keywish/keywish-panther-tank/README.md

# Please Contact Us

Technical support email: abbott@emakefun.com </br>
Sales email: ken@keywish-robot.com</br>
The latest information download address: https://github.com/keywish/keywish-panther-tank
# The branch switch method
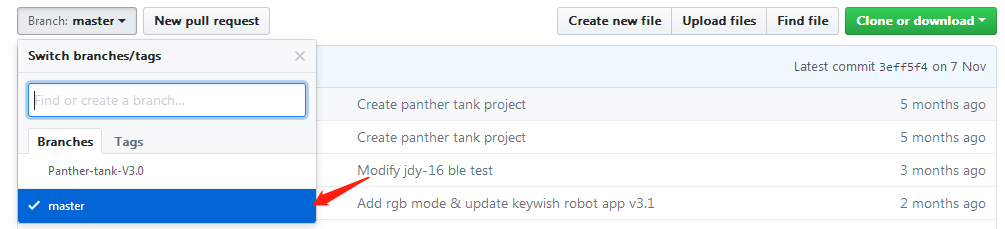
[picture p1: Mast Branch Choose.png]

# Panther-tank
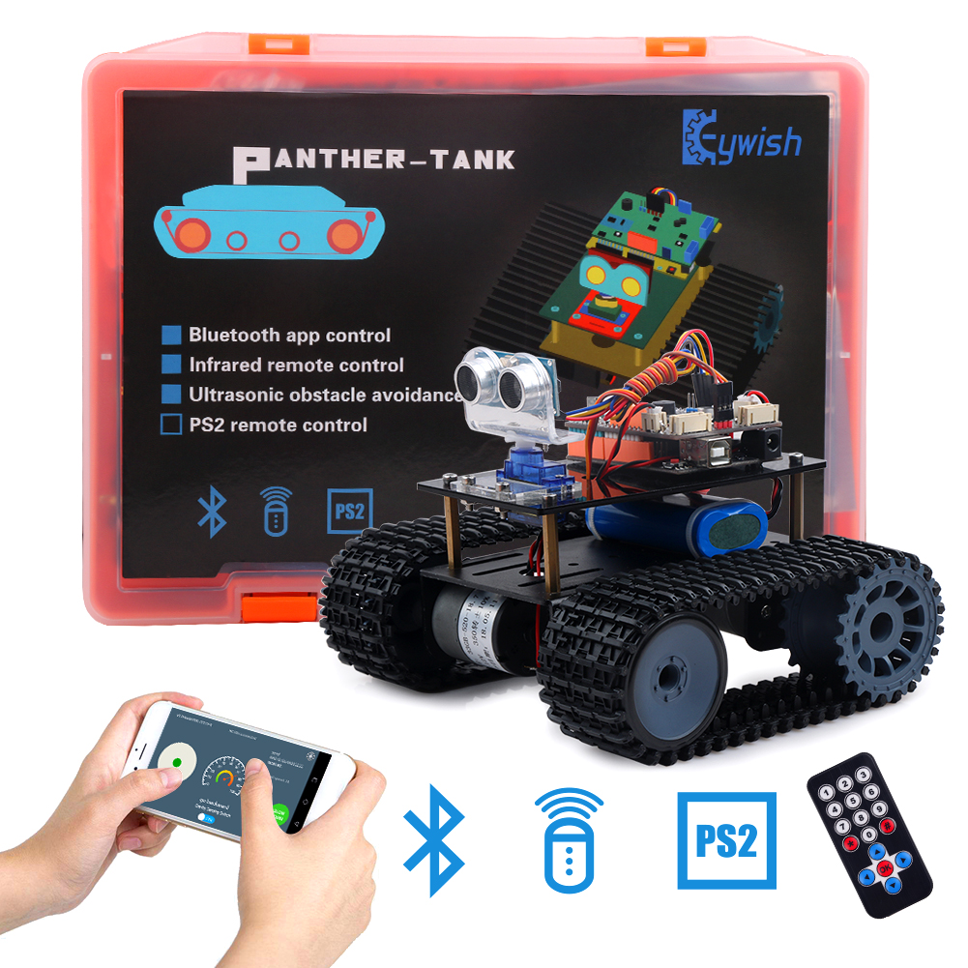
[picture p2: Panther-tank.jpg]


# Product Introduce
"Tank" is ATMEGA328P-PU as the main control chip, and TB6612FGN is used as a multi-functional
crawler car for motor drive chip. Compared with the traditional car, "Tank" is also equipped with wireless
control (Bluetooth, infrared remote control). It can automatically avoid obstacles. Of course, Maker can also
add or subtract other functions through its own Idea, such as adding automatic tracking, PS2 gamepad,
adding wifi control, robotic arm, etc.
"Tank" is equipped with all kinds of materials, technical manuals, routines, etc., and teaches you from
entry to proficiency. Every electronic enthusiast can easily get started and realize the functions they want.

# Feature

*	High power all metal geared motor</br>
*	Integral stamping molding kit,easier Installation,tighter</br>
*	2400mAH,7.4v ,rechargeable li-battery,longer battery life,and more dynamic</br>
*	2 RGB turn lights</br>
*	Buzzer Turn around reminder</br>
*	Infrared remote control</br>
*	Android App control</br>

# Required Best Buy Links
[Buy on Amazon]( https://www.amazon.com/dp/B07CFX53W4 ) </br>
[Buy on Aliexpress]( https://www.aliexpress.com/store/product/Tank-Robot-for-Arduino-UNO-R3-Smart-Cars-Super-Starter-Kit-APP-RC-Gravity-Sensing-Remote/3269016_32919990916.html)

# Download method
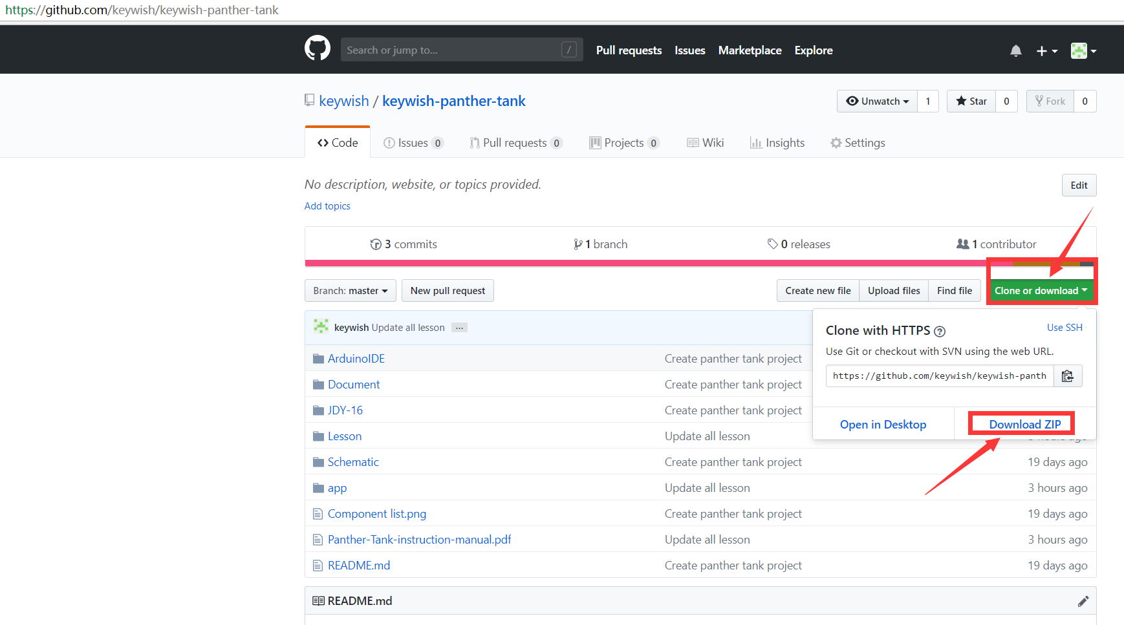
[picture p3: Image.png]
