keywish/keywish-panther-tank/(threads)

Thread 2 (2020-09-20):

Как ограничить угол сервомотора?

lembios, 2020-09-20:
Добрый день. Сгорел сервомотор. Купил новый, но максимальный угол поворота 178 градусов. Если в режиме управления от 0 ставить до 180 - то не реагирует, если от 0 до 178 - ок. Как ограничить максимальный угол поворота до 178 градусов в скетче?
