keywish/keywish-panther-tank/Schematic/MotorDriverBoard_V5.0.pdf

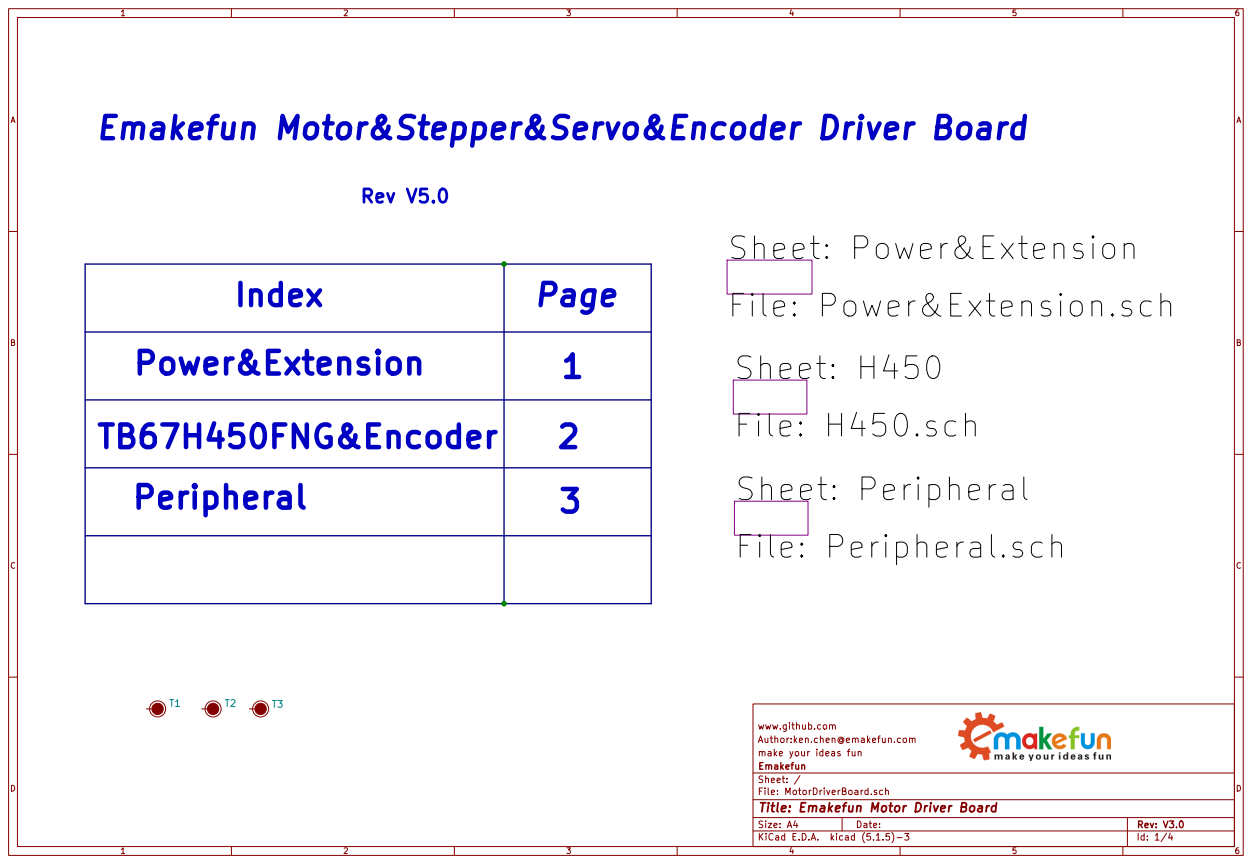
[picture p72: page 1]

Sheet: Power&Extension
File: Power&Extension.sch
Sheet: H450
File: H450.sch
Sheet: Peripheral
File: Peripheral.sch

Index | Page

Peripheral | | 3

www.github.com
Author:ken.chen@emakefun.com
File: MotorDriverBoard.sch Sheet: / Emakefun make your ideas fun

Id: 1/4 Title: Emakefun Motor Driver Board

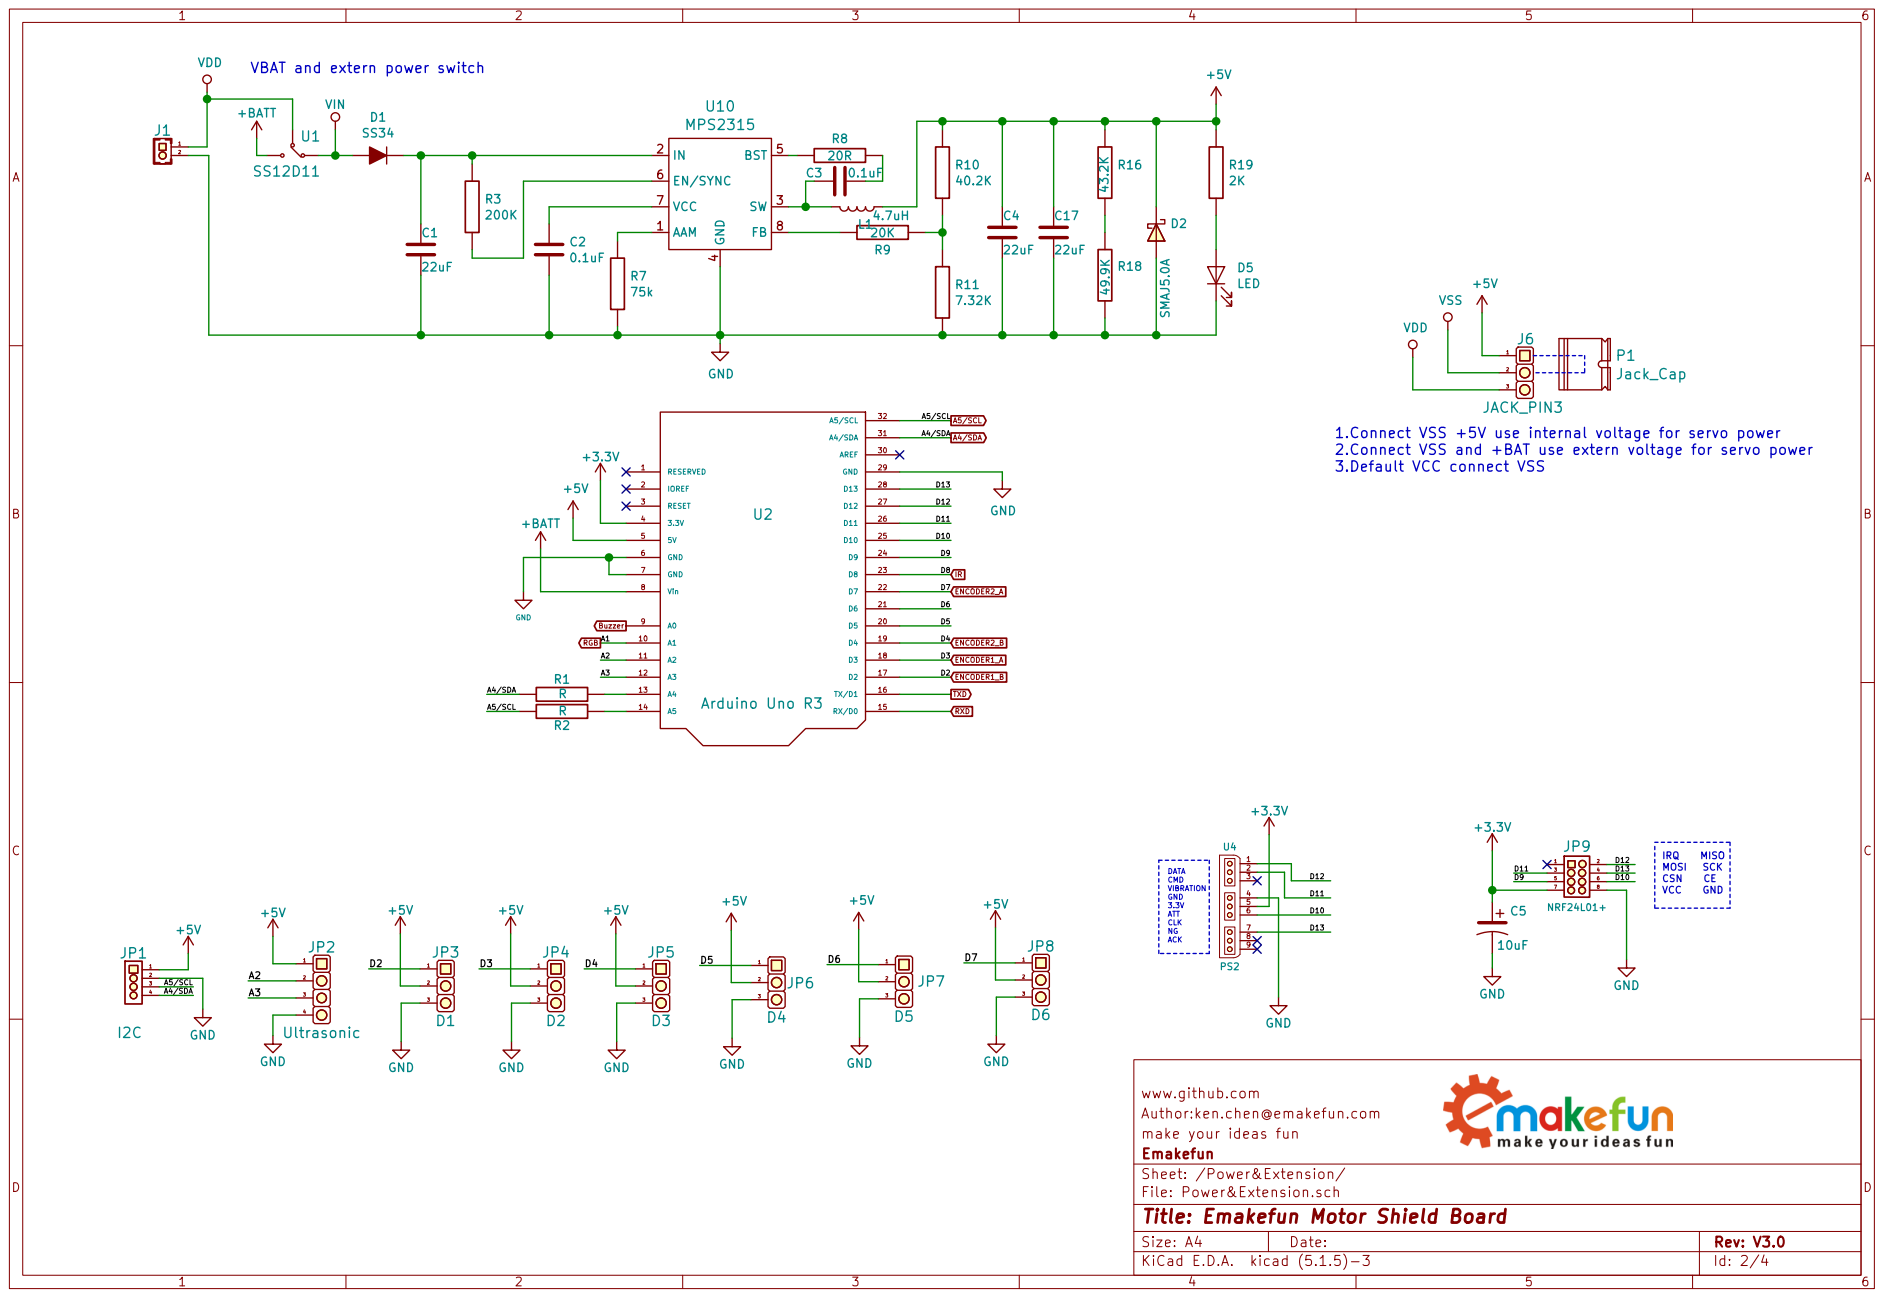
[picture p73: page 2]

VBAT and extern power switch

4 BST 5 EN/SYNC 6 VCC 7 FB 8 U10 MPS2315

1.Connect VSS +5V use internal voltage for servo power
2.Connect VSS and +BAT use extern voltage for servo power
3.Default VCC connect VSS

IRQ MISO MOSI SCK CSN CE

DATA CMD VIBRATION GND 3.3V ATT CLK NG ACK | 2

www.github.com
Author:ken.chen@emakefun.com
File: Power&Extension.sch Sheet: /Power&Extension/ Emakefun make your ideas fun

Id: 2/4 Title: Emakefun Motor Shield Board

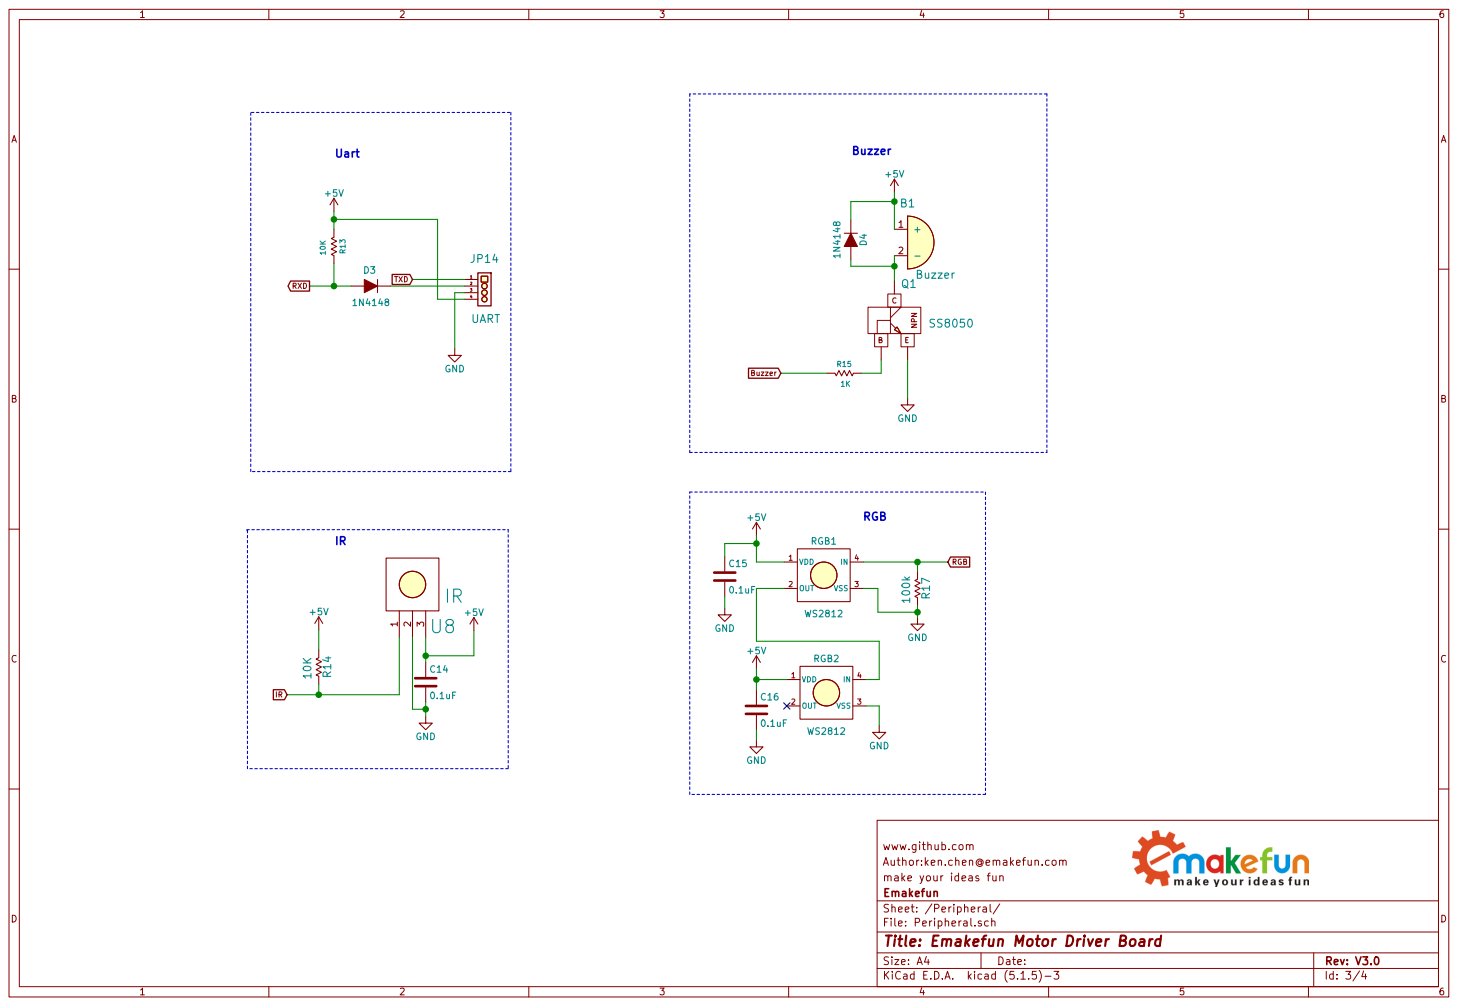
[picture p74: page 3]

www.github.com
Author:ken.chen@emakefun.com
Sheet: /Peripheral/ Emakefun make your ideas fun

File: Peripheral.sch
Id: 3/4 Title: Emakefun Motor Driver Board

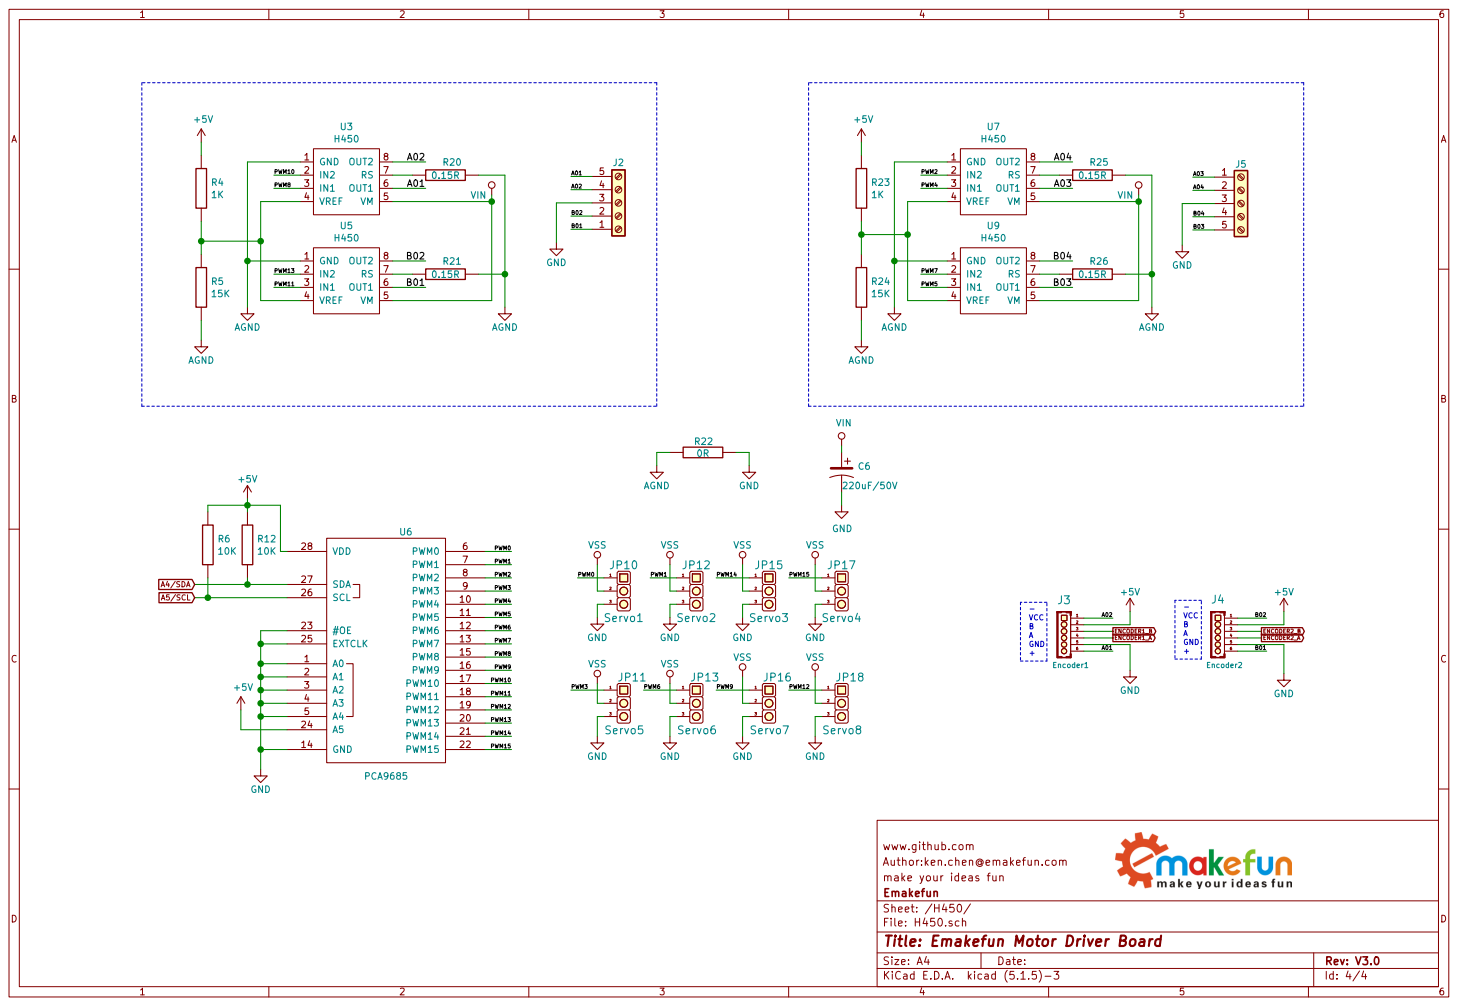
[picture p75: page 4]

www.github.com
Author:ken.chen@emakefun.com
File: H450.sch Sheet: /H450/ Emakefun make your ideas fun

Id: 4/4 Title: Emakefun Motor Driver Board
