keywish/keywish-panther-tank/(commit log)

2018-08-13 Add ultrasonic demo
2018-08-30 Update all lesson
    1.Fix instruction manual some error
    2.Review all lesson code
    3.update apk version 2.0-20180830
    [AlarmSound.ino, PantherTank_Bluetooth.ino, PantherTank_IR.ino, PantherTank_Ultrasound.ino]
2018-08-30 Update motor driver Schematic v2.0
2018-12-26 更新文件库，解决Arduino的版本兼容的问题
2019-01-24 Ultrasonic.cpp Compatible with Arduino IDE 1.8.8
